charbelcbadr/TFE4152-Final-Project/DICProject.pdf

# Design of Integrated Circuits (TFE4152): Digital Pixel Sensor Project

Charbel Badr, ID: 557389 and Harish Nagaruru, ID: 557392

Abstract—In this paper, we propose a method of stacking digital pixel sensors in a 2x2 array. It is dealt with from the analog and digital perspectives. The results are encouraging and show that the overall system is coherent, robust and efficient.

I. INTRODUCTION
The design of image sensors has long been under research. Before the prevalence of the digital domain, the image sensors were mainly of analog form. The sensors constitute the bedrock of technologies such as cameras and their efficiency is something vital for improved enhancements. This being said, we will look at the work done in [1], where they implemented a 355x288 digital pixel sensor and implement a simplified 2x2 array of digital pixel sensors. More specifically, we will focus on implementing a comparator using optimized dimensions transistors and control the states of the pixel array through the implementation of a state machine. We will simulate the analog part of the system in NgSpice and the digital part using iVerilog.
Previous works such as that of the authors in [1] focused on implementing an array of pixels by designing multiple pixel circuits in parallel. The pixel circuits constituted of a photogate, a comparator and an 8 bit memory cell. They used a photogate instead of photodiode due to the latter’s high leakage. The photogate circuit used thick oxide transistors rather than thin oxide ones to avoid leakage currents. The comparator used a differential gain followed by a single-ended gain and an inverter. Lastly, the memory part were implemented using a 3T dynamic memory cells which can accomodate a hold time of 10ms and have a high speed readout. The proposed method achieved a speed of 10,000 frames per second with minimal power consumption of 50mW. Lately, the authors in [2] have implemented a video graphic array by the use of 640x480 time of flight CMOS sensors to achieve a depth map with the fixed pattern phase noise being compensated.
The rest of this paper is organized as follows: Section II offers a theoretical background of the technologies discussed in this paper. Section III provides the technical design or implementation of the proposed system. Section IV offers the experimental results of the system. Section V discusses the analysis of the results found. Finally, Section VI and Section VII provide a conclusion to the paper along with the future scope of the system.

II. THEORY
In this section, we will explain in technical terms the main building blocks referred to in [1] as that is reflected in our proposed design. The three main blocks as discussed previously are the photogate, the comparator/analog-to-digital converter (ADC) and the memory block. We will also mention the importance of gray counters.
A. Photogate Circuit

The photogate circuit can be shown in Fig. 1 and will be explained further.

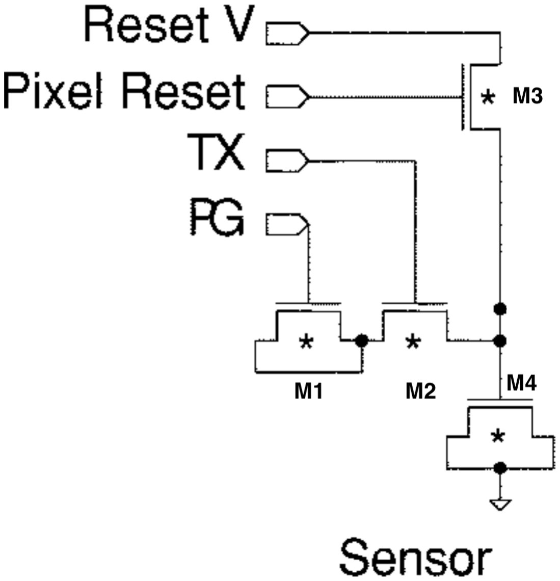
[picture p1: figure]

Fig. 1. Photogate Circuit

From the way these transistor are configured, M1 is the photogate, M2 and M3 are technically switches and M4 is modeled as a capacitor. That means the second stage after this circuit either carries the value of the photogate exposure or is reseted.

B. Comparator / ADC

The comparator circuit can be shown in Fig. 2 and will be explained further.
From the way this circuit looks, M5 acts as a current source in which it is branched into the differential pair (M3,M4). Also it can be seen that M1 and M2 act as a current mirror. Thus based on the gate source voltage of M3 and M4, we will determine which branch has a higher current value. This will affect the voltage drive of the node in between M2 and M4 based on the comparison of the ramp and input signal value. This node is then fed into the M6,M7 circuit which results in an output proportional to the comparison value in which it is fed to an inverter (M8,M9).

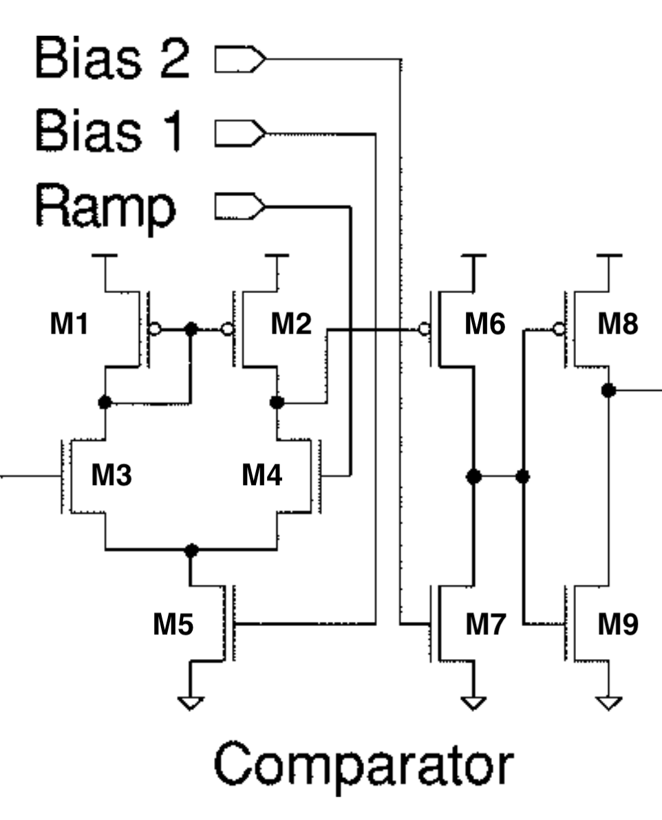
[picture p2: figure]

Fig. 2. Comparator Circuit

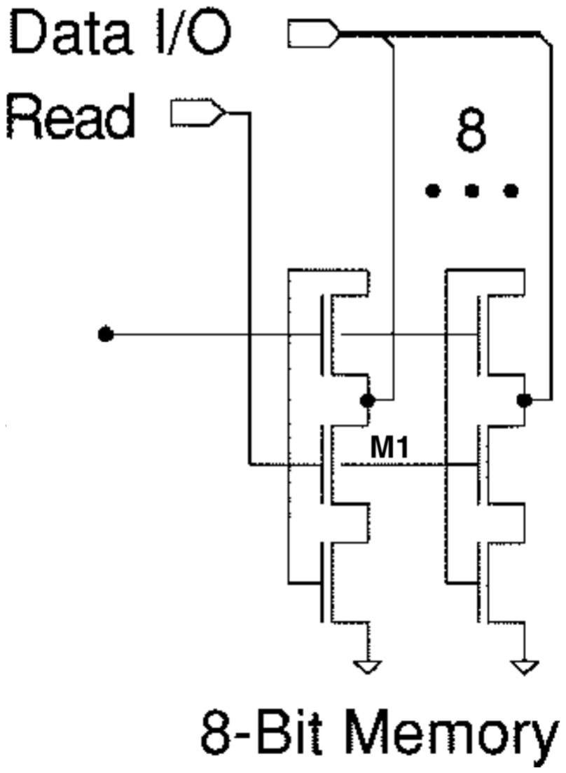
[picture p3: figure]

Fig. 3. Memory Circuit

C. Memory Circuit

The memory circuit can be shown in Fig. 3 and will be explained further.
In this circuit, transistor M1 acts as a switch when we want to read out the value. As long as the comparator output is not zero (conversion process is not done), we keep on updating the memory by Data IO until we stop when comparator is high and we store the value.
D. Gray Counters

The importance of gray code lies in the fact that the upcounting process changes 1 bit at a time and thus the switching is minimized and reliability is increased [3]. This significantly lowers the possibility of glitches in the system.

III. IMPLMENTATION

In this section, we will describe our work done in the analog and digital domains. For the analog part, we only implemented the comparator in terms of transistors. The photogate circuit and the memory was supplied by DICEX [4]. In the digital part, we organized the state machine which controls the behaviour of a 2x2 pixel array.

A. Comparator Circuit
We designed this circuit by getting inspired by the work of
[1] and building up our circuit in NgSpice. The circuit can be found in Fig. 4 where we combine the two bias signals into one.

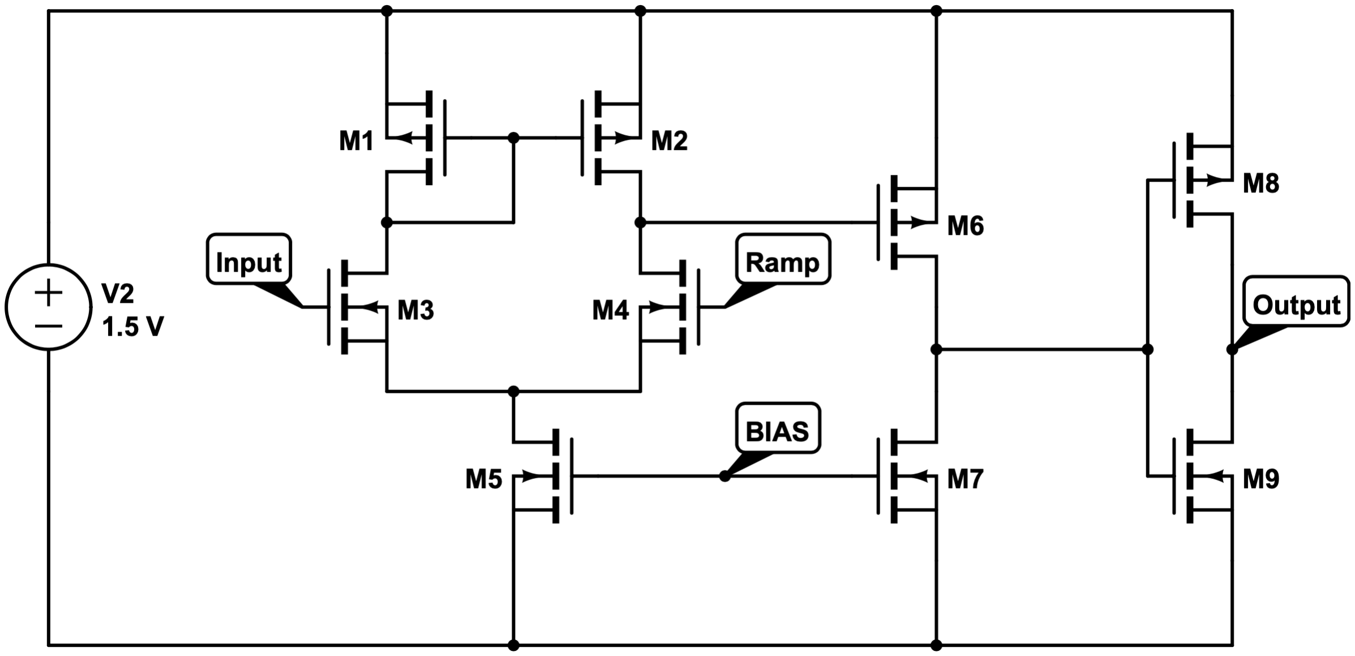
[picture p4: figure]

Fig. 4. Comparative Circuit

We chose the following values in Table I for our transistors width and lengths.

TABLE I
WIDTHS AND LENGTHS OF THE TRANSISTORS
Transistor | Width [µm] | Length [µm]
M1 | 0.5 | 0.5
M2 | 0.5 | 0.5
M3 | 0.5 | 0.15
M4 | 0.5 | 0.15
M6 | 0.5 | 0.15
M7 | 0.5 | 0.15
M8 | 0.5 | 0.15
M9 | 0.5 | 0.15

We chose the bias current to be equal to 1µA. We also chose as a baseline two length values for our transistors which are 0.15µm and 0.5µm. We determine the width based on the following formula:

µA =

µA
sq
× W/L | (1)

W =

µA

µA
sq
× L | (2)

Referencing the lecture on Spice, we determine that our current mirrors need to be in strong inversion and our differential pair should be in weak inversion. The current in the two branches above M5 is almost 0.5µA. For the p-mos current mirror, the µA/sq= 1 for L=0.5µm. Thus W is 0.5µm.For the n-mos differential pair, the µA/sq= 0.2 for L=0.15µm. Thus W is 0.5µm. For the bias current mirror, we also need it in strong inversion. Thus, we used a NCHCM model.
In a nutshell, the comparator receives a ramp function and an input analog function in which they are continuously compared up to the point where the ramp value intersects the input signal. After that a trigger is initiated that the ramp becomes higher than the input value. This is a form of analog to digital conversion.
B. Digital Part

For the digital part, our aim is to modularize the testbench that we initially received in DICEX [4]. The testbench should only aim to test a module without further manipulations related to the control of the system. Thus, for this purpose, we design a system based on independent modules (state machine and pixel array) and we use a testbench for each one created to verify its working mechanism.
The pixelArray contains a 2x2 pixel sensor in which pixel sensors 1 and 2 supply their data on the higher nibble of the output when needed and the pixel sensors 3 and 4 supply their data on the lower nibble when needed. The control of the system array is found in pixelState which supplies the control signals based on the clock and reset. Figure 5 below better explains the overall digital part.

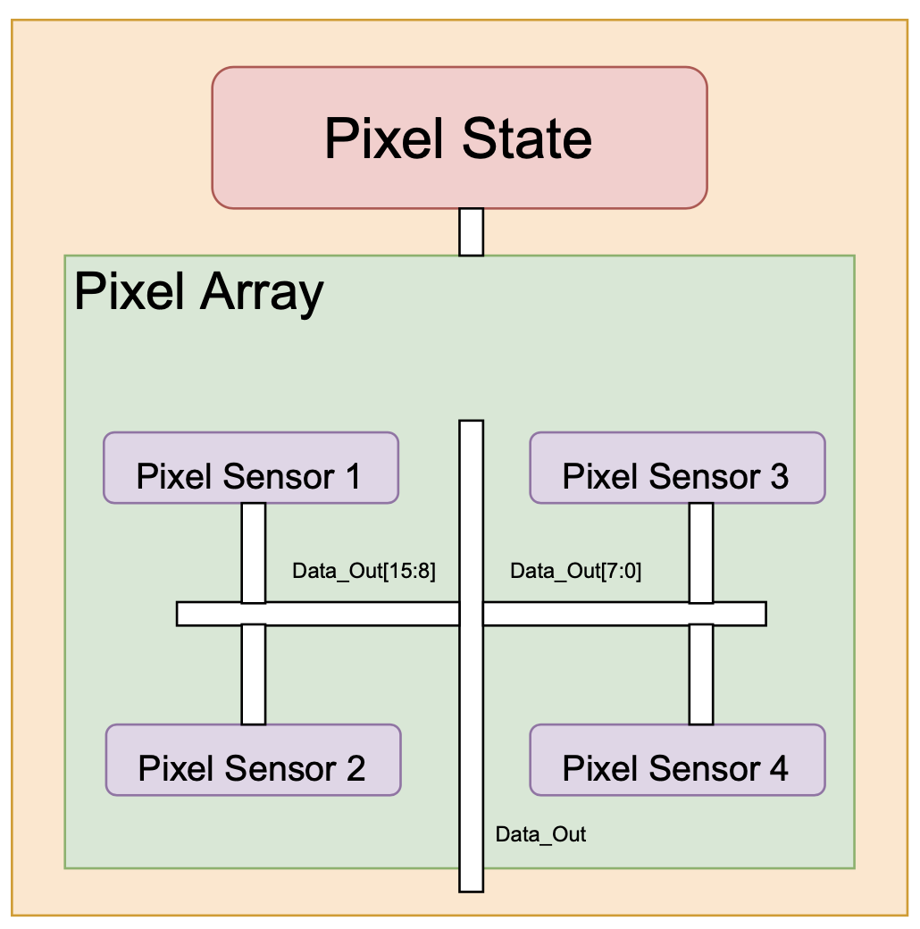
[picture p5: figure]

Fig. 5. Digital Schema

Our design choice was to read pixel sensor 1 on Data Out [15:8] and pixel sensor 3 on Data Out [7:0] when a READ1 signal is supplied. Moreover, we chose to read pixel sensor 2 on Data Out [15:8] and pixel sensor 4 on Data Out [7:0] when a READ2 signal is supplied.
This being said, we only added 2 states to the already present state machine which are READ1 and READ2. This can be better shown in Figure 6.
The state machine starts with ERASE state and proceeds with the states as shown in the arrows. Each state loops in itself for a certain amount of clock rising edges defined by the metric ”c [name]”. The IDLE state is not added in the figure for reduced complexity. After the completion of each state, they jump into the IDLE state for a short period of time before continuing their path as shown in the state machine.

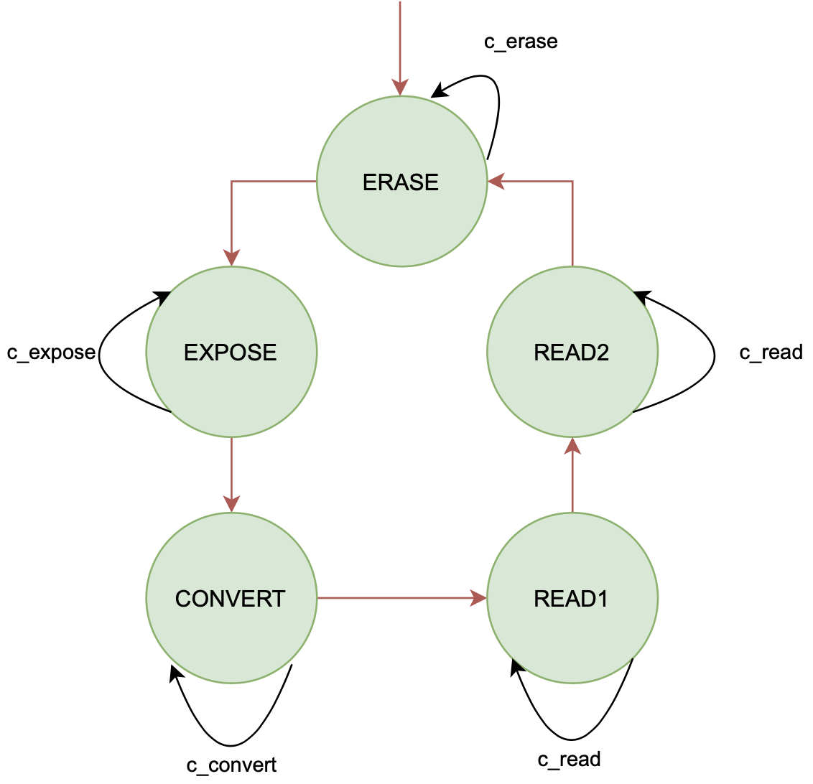
[picture p6: figure]

Fig. 6. State Machine

IV. RESULTS
In this section, we will demonstrate the results of our systems in the analog and digital domain.
A. Analog Domain
To start with, we verify that the control signals are working in the right order and quite the right time. In this context, ERASE (pink color) and READ (green color) have a small duration while the EXPOSE (blue color) and CONVERT (orange color) have a relatively longer duration. This can be seen in Figure 7 below.

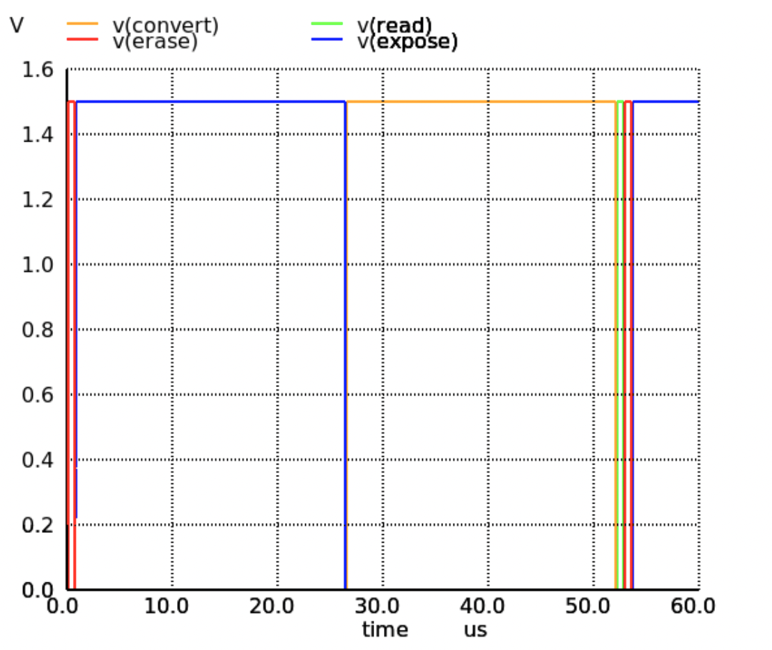
[picture p7: figure]

Fig. 7. Control Signals

For the purpose of verifying that the comparator works properly, we use the transient analysis to test its functionality. Figure 8 below shows two graphs that are similar with the only difference that the graph to the right has more pixel exposure time. This results in a lower voltage (vstore - blue color). This should have been higher voltage but can be explained as vstore is an inverted signal. Focusing only on the left graph, we can see that as the ramp function (red color) reaches the level of the input (blue color), the vcmp out (yellow color) goes low. This proves that the comparator works properly.

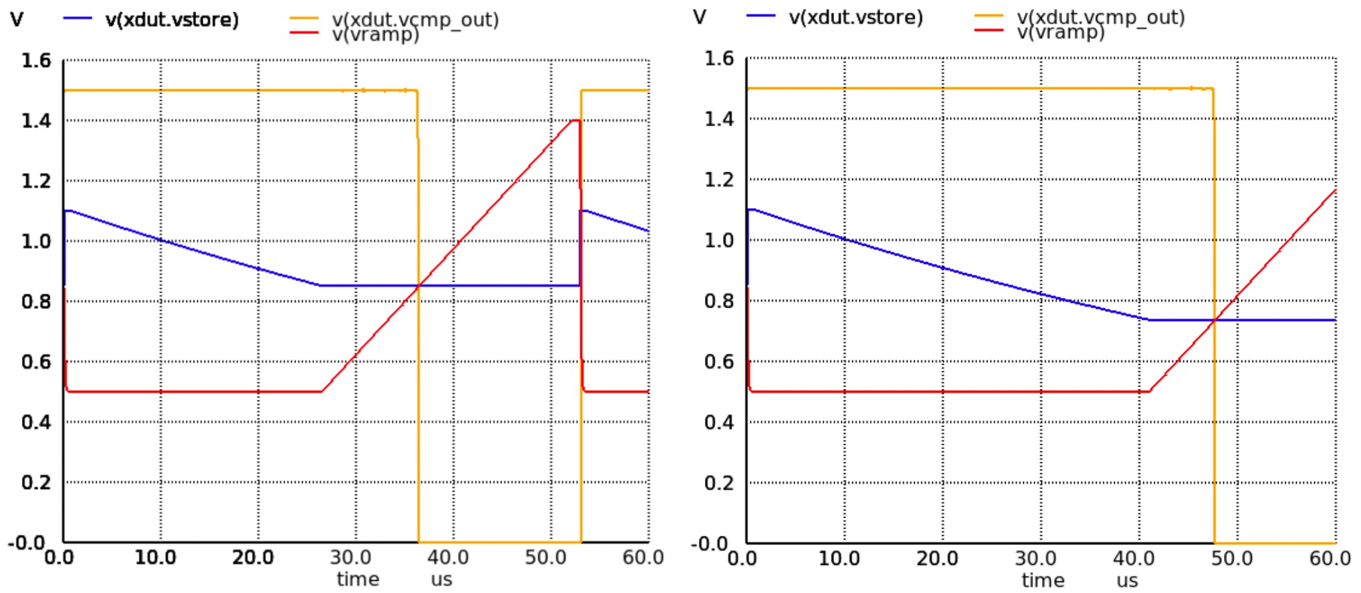
[picture p8: figure]

Fig. 8. Comparator Behaviour

For the purpose of checking the delay of the comparator, we probe the signal and subtract the x values which represents time from the initial fall of the vcmp out to when it actually becomes 0V. Figure 9 shows the values received from terminal. The delay value is then almost 247 ns.

Fig. 9. Terminal Values

B. Digital Part
In the digital part, we created testbenches to verify that several parts of our system works. The first of which is the transition of states based on the time inputted in the program. This is verified through Figure 10 which shows that the states are shifted as shown in the state machine.

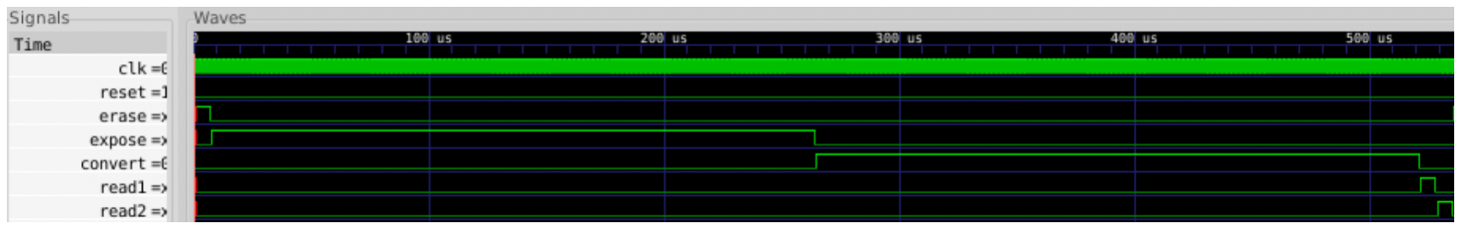
[picture p9: figure]

Fig. 10. State Machine Timeline

In the process of conversion, we used the gray code instead of normal upcounting. Thus, we also look at that portion in the waveform to verify it is working properly. This is shown in Figure 11.

Fig. 11. Gray Code Counter

As it can be seen, the normal sequence of gray code up counting is verified.
The last thing that can be verified from the testbench is the reading of values from the pixel sensors to the 16-bit output in the right manner. Figure 12 shows the 4 pixel sensors’ output along with the final 16-bit output.

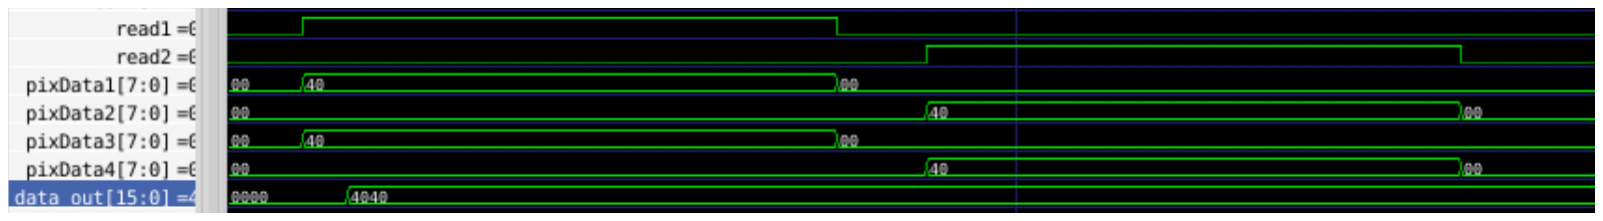
[picture p10: figure]

Fig. 12. Reading Out Pixel Values

It can be seen from Fig. 12 that when READ1 is on, then the pixel sensor 1 and pixel sensor 3 are being read, each of which having a value of 0x40. The data out is simply the concatenation of the two values where pixel sensor 1 is the higher nibble and pixel 3 sensor is the lower nibble. The same applies to pixel sensor 2 and 4 when READ2 signal is on. A final thing to mention here is that our verilog modules are synthesizable

V. DISCUSSION
The results shown in the previous section verifies that the implementation works. The comparator in the analog domain works as required to transform the analog value into a digital one. The time factor here is important because excessive delays could not capture the exact value of the input. Thankfully, our comparator has a delay in the order of magnitude of nanoseconds. As for the digital part, the conversion would have incurred minor glitches, hadn’t we used the gray code counter. The gray code counter increases the credibility of the system. Moreover, the reading of two pixel sensors simultaneously into a 16-bit output made the system faster than waiting for the reading of every pixel sensor sequentially. Overall speaking, the system could have encountered minor issues from certain subsystems, but our design helped in making the it avoid such errors.

VI. FUTURE WORK
As for the future works, the system can be enhanced using the following methods:
- Implementation of hardware for the proposed system instead of keeping it limited to simulations.
- Addition of a higher number of pixel sensor elements in the pixel sensor array
- Using different kinds of analog to digital convertors such as successive approximation.

VII. CONCLUSION
In this paper, we introduced an enhanced method of using and reading a 2x2 pixel array by dealing with it from two different aspects, namely from analog and digital perspectives. Our implementation focused on the simulation from SPICE and Verilog. The results proved that our system works in the right manner and achieve their purpose.

VIII. APPENDIX
This repository can be found using the following link: https://github.com/charbelcbadr/TFE4152-Final-Project.git The code of the modules can be found here:

A. Analog Part-Spice

. SUBCKT PIXEL SENSOR VBN1 VRAMP VRESET ERASE EXPOSE READ
+ DATA 7 DATA 6 DATA 5 DATA 4 DATA 3 DATA 2 DATA 1 DATA 0 VDD VSS

XS1 VRESET VSTORE ERASE EXPOSE VDD VSS SENSOR

XC1 VCMP OUT VSTORE VRAMP VBN1 VDD VSS COMP

XM1 READ VCMP OUT DATA 7 DATA 6 DATA 5 DATA 4 DATA 3 DATA 2 DATA 1 DATA 0 VDD VSS MEMORY

. ENDS

. SUBCKT MEMORY READ VCMP OUT
+ DATA 7 DATA 6 DATA 5 DATA 4 DATA 3 DATA 2 DATA 1 DATA 0 VDD VSS

XM1 VCMP OUT DATA 0 READ VSS MEMCELL XM2 VCMP OUT DATA 1 READ VSS MEMCELL XM3 VCMP OUT DATA 2 READ VSS MEMCELL XM4 VCMP OUT DATA 3 READ VSS MEMCELL XM5 VCMP OUT DATA 4 READ VSS MEMCELL XM6 VCMP OUT DATA 5 READ VSS MEMCELL XM7 VCMP OUT DATA 6 READ VSS MEMCELL XM8 VCMP OUT DATA 7 READ VSS MEMCELL

. ENDS

. SUBCKT MEMCELL CMP DATA READ VSS
M1 VG CMP DATA VSS nmos | w=0.2 u | l =0.13 u
M2 DATA READ DMEM VSS nmos | w=0.4 u | l
=0.13 u
M3 DMEM VG VSS VSS nmos | w=1u | l =0.13 u
C1 VG VSS 1p
. ENDS

. SUBCKT SENSOR VRESET VSTORE ERASE EXPOSE VDD VSS

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

* Switch t o expose p i x e l
BR2 VPG VSTORE I =V(EXPOSE) *V(VSTORE, VPG) / 1 k

* Model p h o t o c u r r e n t Rphoto VPG VSS 1G
. ENDS

. SUBCKT COMP VCMP OUT VSTORE VRAMP VBN1 VDD VSS

* Model c o m p a r a t o r
M1 VG1 VG1 VDD VDD pmos w=0.5 u l =0.5 u
M2 VD2 VG1 VDD VDD pmos w=0.5 u l =0.5 u
M3 VG1 VSTORE VS3 VS3 nmos w=0.5 u l =0.15 u M4 VD2 VRAMP VS3 VS3 nmos w=0.5 u l =0.15 u XM5 VS3 VBN1 VSS VSS NCHCM2
M6 VD6 VD2 VDD VDD pmos w=0.5 u l =0.15 u M7 VD6 VBN1 VSS VSS nmos w=0.5 u l =0.15 u M8 VCMP OUT VD6 VDD VDD pmos w=0.5 u l =0.15 u
M9 VCMP OUT VD6 VSS VSS nmos w=0.5 u l =0.15 u

. ENDS

B. Digital Part - Verilog

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

) ;

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

end

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

end

//−−−−−−−−−−−−−−−−−−−−−−−−−−
/ / Readout
//−−−−−−−−−−−−−−−−−−−−−−−−−−
/ / Assign d a t a t o bus when pixRead = 0 a s s i g n DATA = READ ? p d a t a : 8 ’bZ ;

endmodule / / r e c o n t r o l

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

PIXEL SENSOR ps1 (VBN1,RAMP, RESET , ERASE , EXPOSE , READ1, p i x D a t a 1 ) ;
PIXEL SENSOR ps2 (VBN1,RAMP, RESET , ERASE , EXPOSE , READ2, p i x D a t a 2 ) ;
PIXEL SENSOR ps3 (VBN1,RAMP, RESET , ERASE , EXPOSE , READ1, p i x D a t a 3 ) ;
PIXEL SENSOR ps4 (VBN1,RAMP, RESET , ERASE , EXPOSE , READ2, p i x D a t a 4 ) ;
i n t e g e r | c o u n t e r ;
/ / Delay c o u n t e r i n s t a t e machine
l o g i c [ 7 : 0 ] | d a t a ;

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

//−−−−−−−−−−−−−−−−−−−−−−−−−−−−
/ / Readout from d a t a b u s //−−−−−−−−−−−−−−−−−−−−−−−−−−−−

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

endmodule

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

p a r a m e t e r ERASE=0 , EXPOSE=1 , CONVERT=2 , READ1=3 , READ2=4 , IDLE =5;

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

P i x e l A r r a y pa (CLK, VBN1,RAMP, VRESET , RESET , ERASE , EXPOSE ,CONVERT, READ1, READ2, DATA OUT) ;

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

endmodule

REFERENCES

[1] Kleinfelder, Lim, Liu, Gamal “A 10 000 Frames/s CMOS Digital Pixel Sensor”, JSSC, VOL 36, NO 12, 2001
[2] M. Keel et al, ”A VGA Indirect Time-of-Flight CMOS Image Sensor With 4-Tap 7- µ m Global-Shutter Pixel and Fixed-Pattern Phase Noise Self-Compensation,” IEEE Journal of Solid-State Circuits, vol. 55, (4), pp. 889-897, 2020.
[3] “What is gray code? and advantages of gray code,” TutsMaster, 02-Feb-2020. [Online]. Available: https://tutsmaster.org/what-is-gray-code-and-advantages-of-gray-code-2/.
[4] C. Wulffern, “Wulffern/dicex: Exercises for design of Integrated Circuits,” GitHub. [Online]. Available: https://github.com/wulffern/dicex.
