charbelcbadr/TFE4152-Final-Project/verilog/pixelState.v

`timescale 1ns / 1ps
 module pixelState(
 input logic clk,
 input logic reset,
 output logic erase,
 output logic expose,
 output logic convert,
 output logic read1,
 output logic read2
 );
 
 parameter ERASE=0, EXPOSE=1, CONVERT=2, READ1=3, READ2=4, IDLE=5;


   logic               convert_stop;
   logic [2:0]         state,next_state;   //States
   integer           counter;            //Delay counter in state machine

   //State duration in clock cycles
   parameter integer c_erase = 5;
   parameter integer c_expose = 255;
   parameter integer c_convert = 255;
   parameter integer c_read = 5;

   // Control the output signals
   always_ff @(negedge clk ) begin
      case(state)
        ERASE: begin
           erase <= 1;
           read1 <= 0;
           read2 <= 0;
           expose <= 0;
           convert <= 0;
        end
        EXPOSE: begin
           erase <= 0;
           read1 <= 0;
           read2 <= 0;
           expose <= 1;
           convert <= 0;
        end
        CONVERT: begin
           erase <= 0;
           read1 <= 0;
           read2 <= 0;
           expose <= 0;
           convert = 1;
        end
        READ1: begin
           erase <= 0;
           read1 <= 1;
           read2 <= 0;
           expose <= 0;
           convert <= 0;
        end
        READ2: begin
           erase <= 0;
           read1 <= 0;
           read2 <= 1;
           expose <= 0;
           convert <= 0;
        end
        IDLE: begin
           erase <= 0;
           read1 <= 0;
           read2 <= 0;
           expose <= 0;
           convert <= 0;

        end
      endcase // case (state)
   end // always @ (state)
   
  // Control the state transitions
   always_ff @(posedge clk or posedge reset) begin
      if(reset) begin
         state = IDLE;
         next_state = ERASE;
         counter  = 0;
         convert  = 0;
      end
      else begin
         case (state)
           ERASE: begin
              if(counter == c_erase) begin
                 next_state <= EXPOSE;
                 state <= IDLE;
              end
           end
           
           EXPOSE: begin
              if(counter == c_expose) begin
                 next_state <= CONVERT;
                 state <= IDLE;
              end
           end
           
           CONVERT: begin
              if(counter == c_convert) begin
                 next_state <= READ1;
                 state <= IDLE;
              end
           end
           
           READ1: begin
             if(counter == c_read) begin
                state <= IDLE;
                next_state <= READ2;
             end
           end
           
           READ2: begin
             if(counter == c_read) begin
                state <= IDLE;
                next_state <= ERASE;
             end
           end
           
           IDLE:
             state <= next_state;
         endcase // case (state)
         if(state == IDLE)
           counter = 0;
         else
           counter = counter + 1;
      end
   end // always @ (posedge clk or posedge reset)
endmodule
